nlbutts/HW-PCB/OpenThermalCamera.kicad_pcb

## KiCad design OpenThermalCamera.kicad_pcb (2020-01-12)

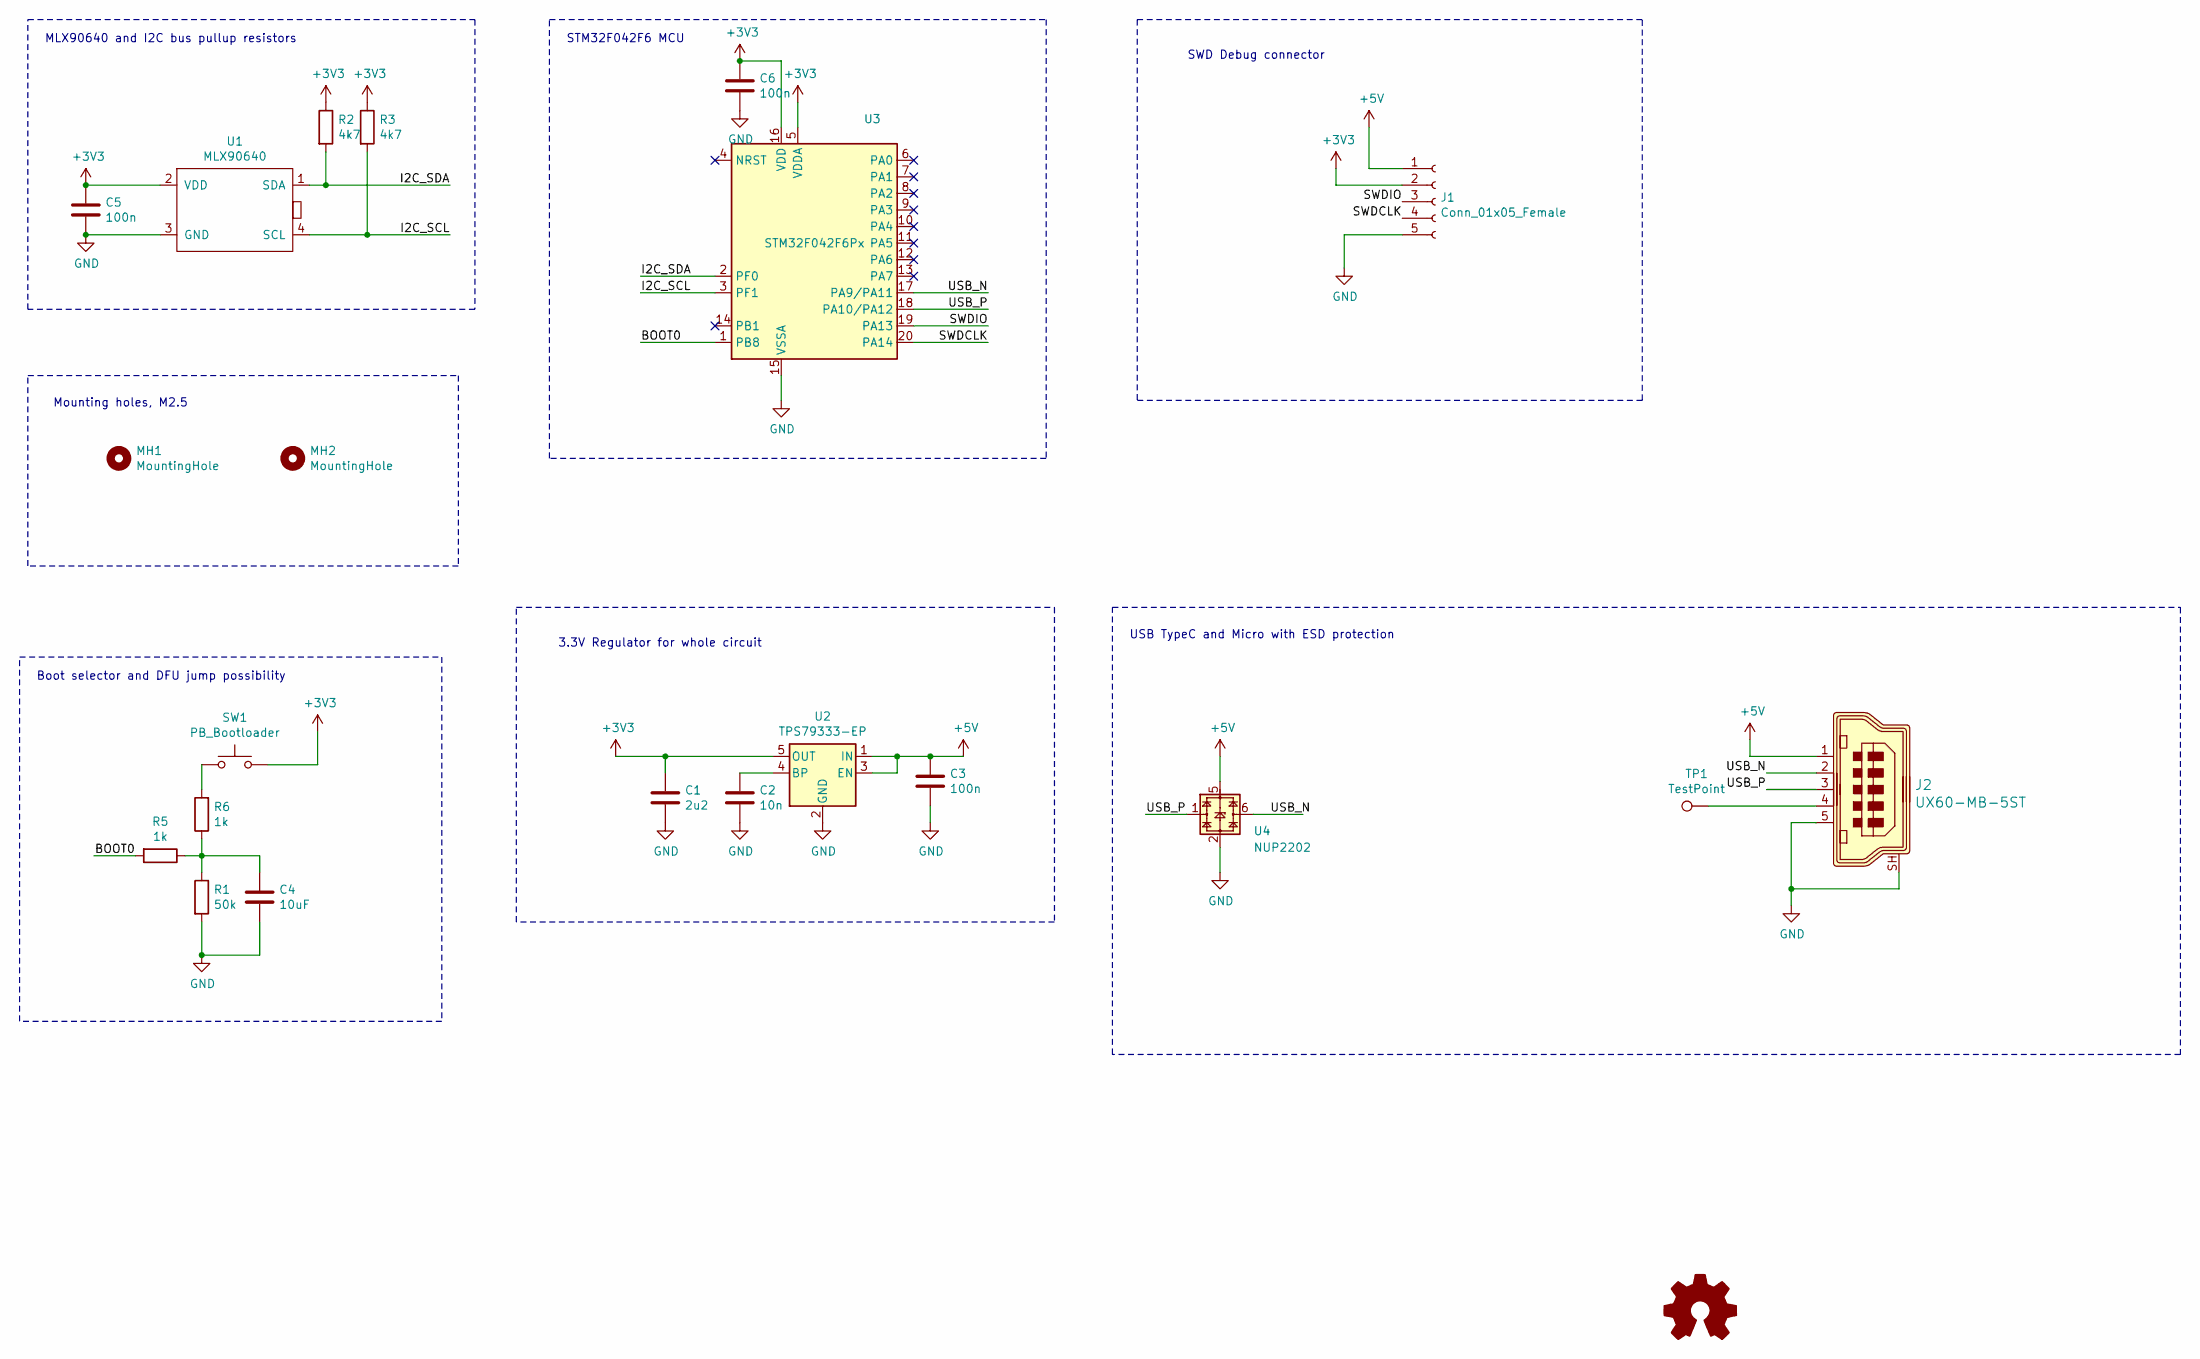
[picture p1: schematic OpenThermalCamera.sch]

Parts:
C1: 2u2; C_0805_2012Metric_Pad1.15x1.40mm_HandSolder; Part Number 2896530
C2: 10n; C_0805_2012Metric_Pad1.15x1.40mm_HandSolder; Part Number 2534050
C3, C6: 100n; C_0805_2012Metric_Pad1.15x1.40mm_HandSolder; Part Number 2496943
C4: 10uF; C_0805_2012Metric_Pad1.15x1.40mm_HandSolder; mfr# C2012X5R1C106K085AC
C5: 100n; C_0805_2012Metric_Pad1.15x1.40mm_HandSolder; mfr# 0805B104K250CT
G1: Logo_Open_Hardware_Small; OSHW-Logo2_7.3x6mm_SilkScreen
J1: Conn_01x05_Female; PinHeader_1x05_P1.27mm_Vertical
J2: UX60-MB-5ST; USB_Mini_B_Female_UX60-MB-5ST; MPN UX60-MB-5ST; Digi-Key_PN H2959CT-ND
MH1, MH2: MountingHole; MountingHole_2.7mm_M2.5
R1: 50k; R_0805_2012Metric_Pad1.15x1.40mm_HandSolder; mfr# CRCW080551K0JNEA
R2, R3: 4k7; R_0805_2012Metric_Pad1.15x1.40mm_HandSolder; mfr# CRCW08054K70FKEA
R5, R6: 1k; R_0805_2012Metric_Pad1.15x1.40mm_HandSolder; mfr# CRCW08051K00FKEAC
SW1: PB_Bootloader; SolderJumper-2_P1.3mm_Open_RoundedPad1.0x1.5mm; Part Number /
TP1: TestPoint; TestPoint_Pad_D1.0mm
U1: MLX90640; Part Number 482-MLX90640ESFBABSP
U2: TPS79333-EP; SOT-23-5; mfr# TPS79333DBVR
U3: STM32F042F6Px; TSSOP-20_4.4x6.5mm_P0.65mm; Part Number 511-STM32F042F6P6TR
U4: NUP2202; SOT-363_SC-70-6; Part Number 2533276

Connections:
+3V3: C1.1, C5.1, C6.1, J1.2, R2.1, R3.1, SW1.2, U1.2 (VDD), U2.5 (OUT), U3.5 (VDDA), U3.16 (VDD)
+5V: C3.1, J1.1, J2.1, U2.1 (IN), U2.3 (EN), U4.5
/BOOT0: R5.2, U3.1 (PB8)
/I2C_SCL: R3.2, U1.4 (SCL), U3.3 (PF1)
/I2C_SDA: R2.2, U1.1 (SDA), U3.2 (PF0)
/SWDCLK: J1.4, U3.20 (PA14)
/SWDIO: J1.3, U3.19 (PA13)
/USB_N: J2.2, U3.17 (PA9/PA11), U4.6
/USB_P: J2.3, U3.18 (PA10/PA12), U4.1
GND: C1.2, C2.2, C3.2, C4.2, C5.2, C6.2, J1.5, J2.5, J2.SH, R1.2, U1.3 (GND), U2.2 (GND), U3.15 (VSSA), U4.2
unnamed: C2.1, U2.4 (BP)
unnamed: C4.1, R1.1, R5.1, R6.1
unnamed 12: J2.4, TP1.1; also elsewhere on the board
unnamed: R6.2, SW1.1

Notes on the sheet:
SWD Debug connector
USB TypeC and Micro with ESD protection
3.3V Regulator for whole circuit
MLX90640 and I2C bus pullup resistors
STM32F042F6 MCU
Boot selector and DFU jump possibility
Mounting holes, M2.5

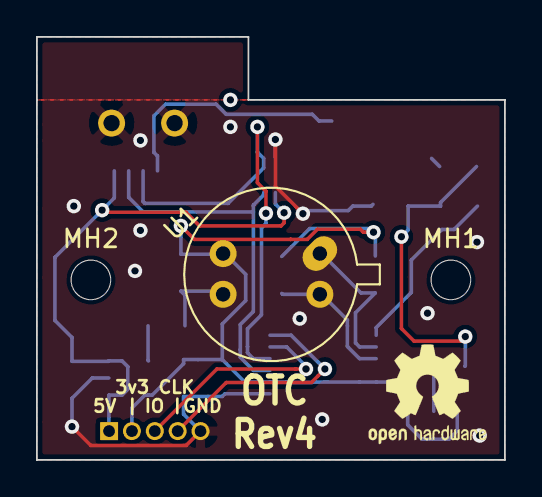
[picture p2: board OpenThermalCamera.kicad_pcb from above]

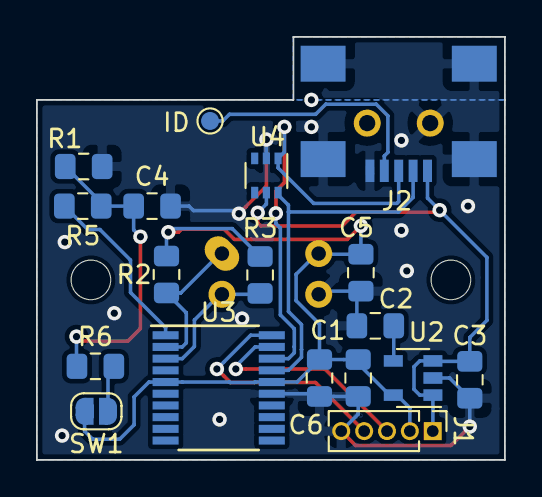
[picture p3: board OpenThermalCamera.kicad_pcb from below]

Board: 2 copper layers, 26.0 x 23.5 mm, 22 parts (18 on the bottom side), 14 nets.

Other parts of the board:
ID: TestPoint; TestPoint_Pad_D1.0mm

Their connections:
unnamed 12: ID.1; also elsewhere on the board
